10100010meow/ANDnXOR_DC25_Badge/README.md

# ANDnXOR_DC25_Badge
AND!XOR Unofficial DEF CON 25 Badge

Eventually we will have all source and gerbers here.
