10100010meow/ANDnXOR_DC25_Badge/manbearpig3.pdf

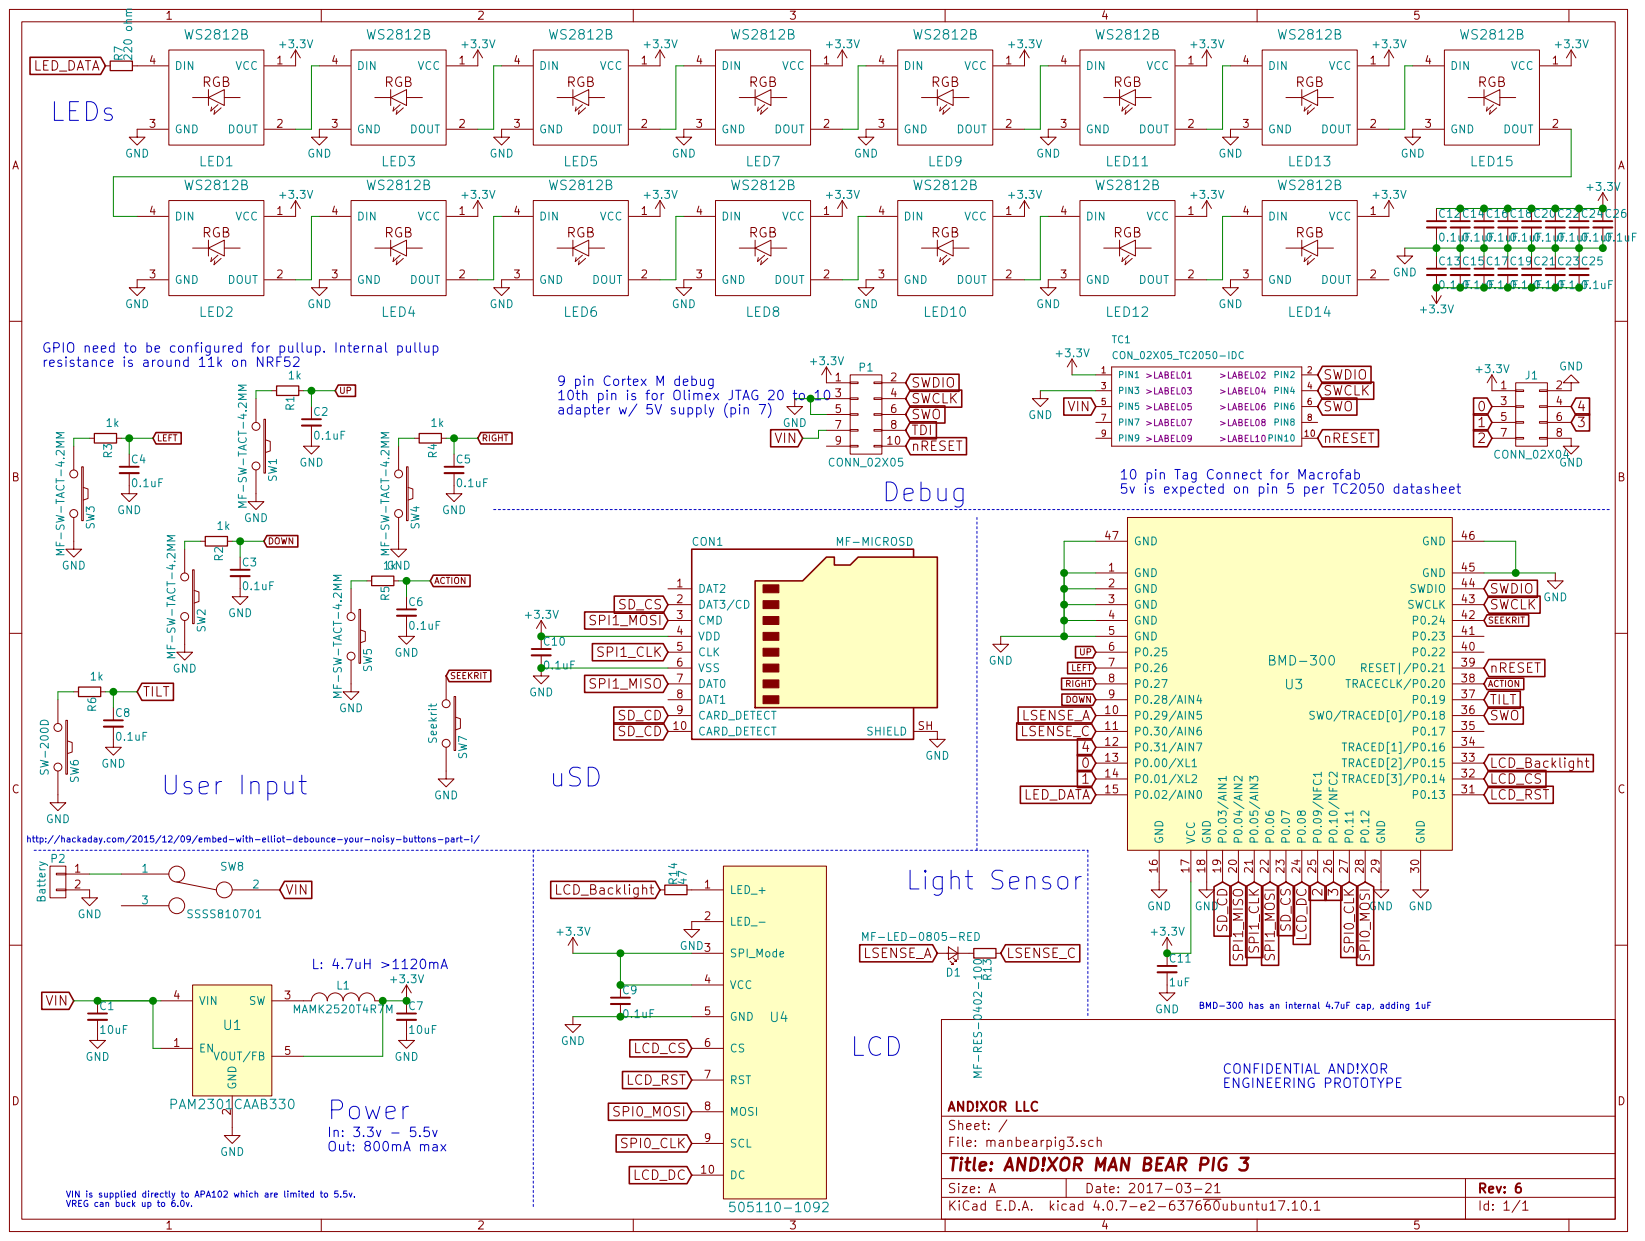
[picture p2: page 1]
