10100010meow/ANDnXOR_DC25_Badge/Brain Slug/brain slug.pdf

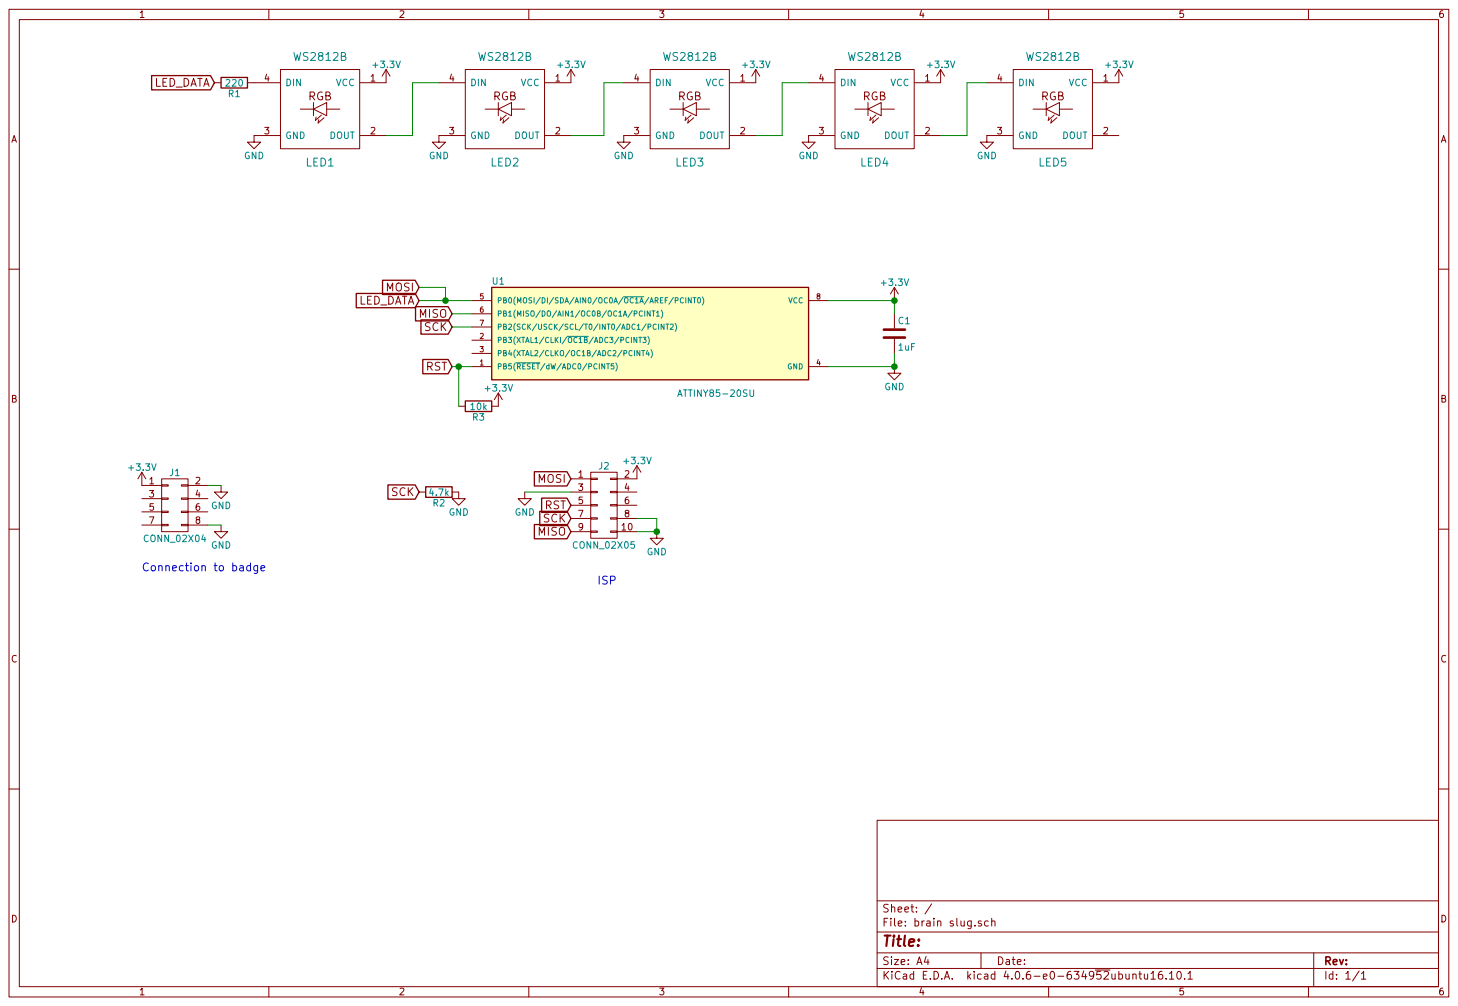
[picture p3: page 1]

File: brain slug.sch Sheet: /
Id: 1/1 Title:
