10100010meow/ANDnXOR_DC25_Badge/(commit log)

2017-07-18 Publishing SD Image.
    [ANDNXOR.cfg, Airplane.cfg, Alien.cfg, Ant.cfg, AstroDdg.cfg, Blinky.cfg, BlinkySC.cfg, Blitz.cfg]
2017-08-06 Added BOM.
2017-08-09 Better late than never.
    [brain slug-B.Cu.gbl, brain slug-B.Mask.gbs, brain slug-B.Paste.gbp, brain slug-B.SilkS.gbo, brain slug-Edge.Cuts.gm1, brain slug-F.Cu.gtl, brain slug-F.Mask.gts, brain slug-F.Paste.gtp]
2017-08-09 Brain slug schematic.
2017-08-10 Public release of final v1.6 source code for the AND!XOR DC25 badge.
    [config.txt]
2017-12-06 Forgot the schematic
